SatcomRadio/DiseqC_Controller/Kicad/3D/SMA.step

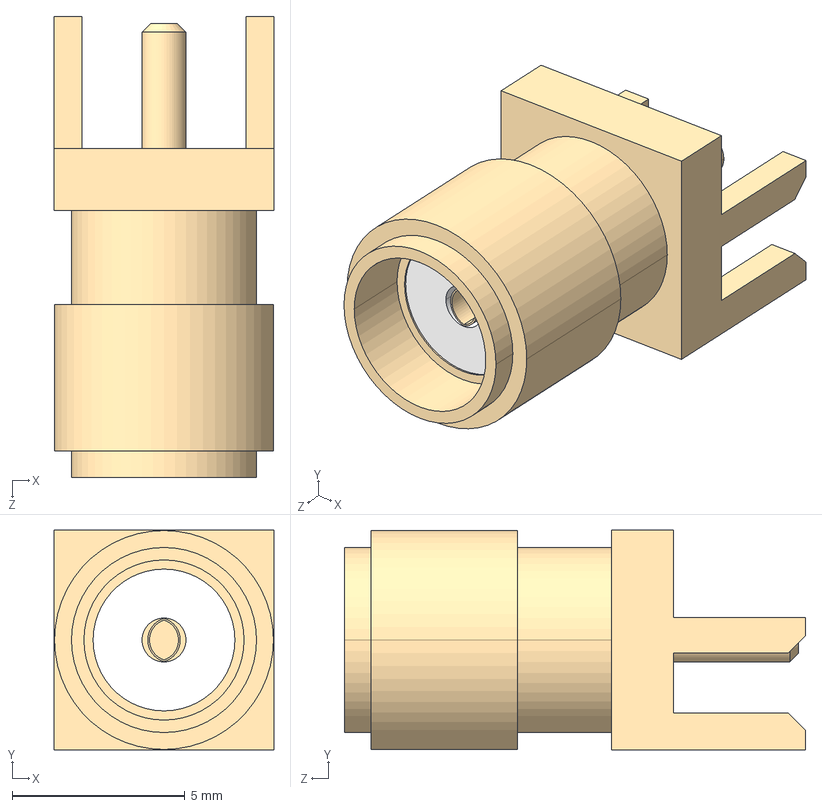
[picture p8: CAD file, 2025-11-17]
Kicad/3D/SMA.step
6.35 x 6.35 x 13.3 mm
