SatcomRadio/DiseqC_Controller/Kicad/3D/StepUp_2A.STEP

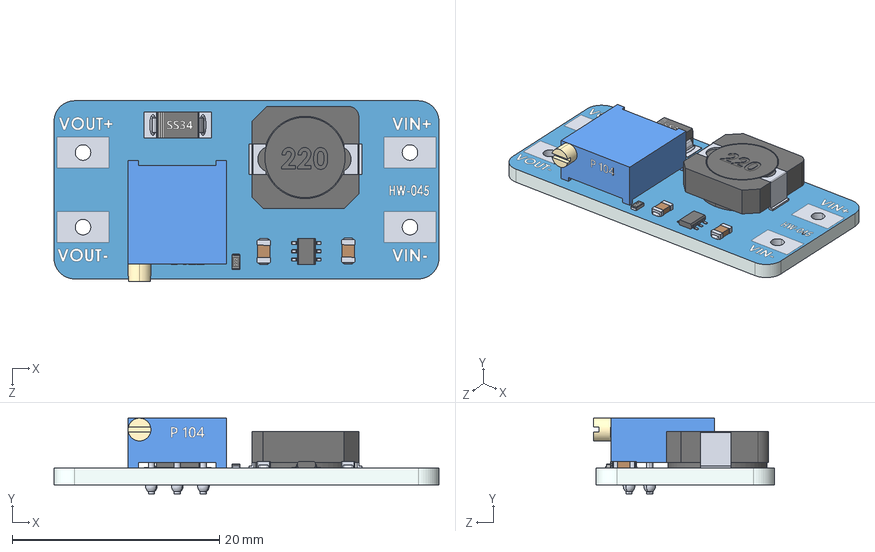
[picture p9: CAD file, 2025-11-17]
Kicad/3D/StepUp_2A.STEP
37.1 x 7.30 x 17.4 mm
MT3608 Converter PCB
smdS537diode
tinySMDResistor222
smdceramiccapacitorbrown x 2
tinysmdChip6pin
HorizonatalTrimmerP104
solder x 3
smbInductor220
