SatcomRadio/DiseqC_Controller/Kicad/3D/SMD_Inductor.step

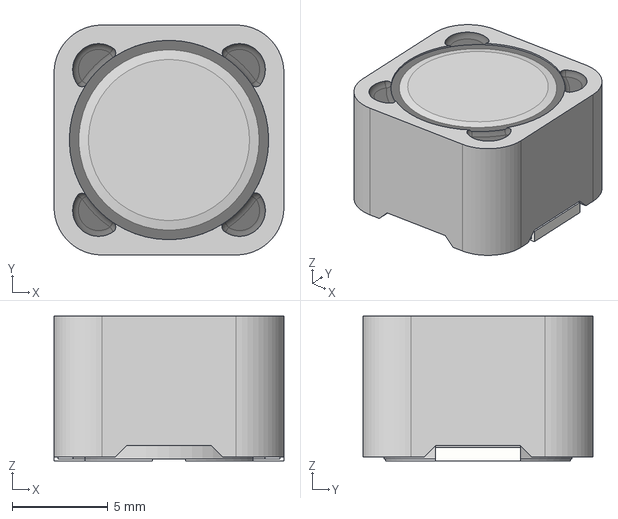
[picture p10: CAD file, 2025-11-17]
Kicad/3D/SMD_Inductor.step
12.0 x 12.0 x 7.56 mm
