SatcomRadio/DiseqC_Controller/Kicad/3D/SMA-angled.STEP

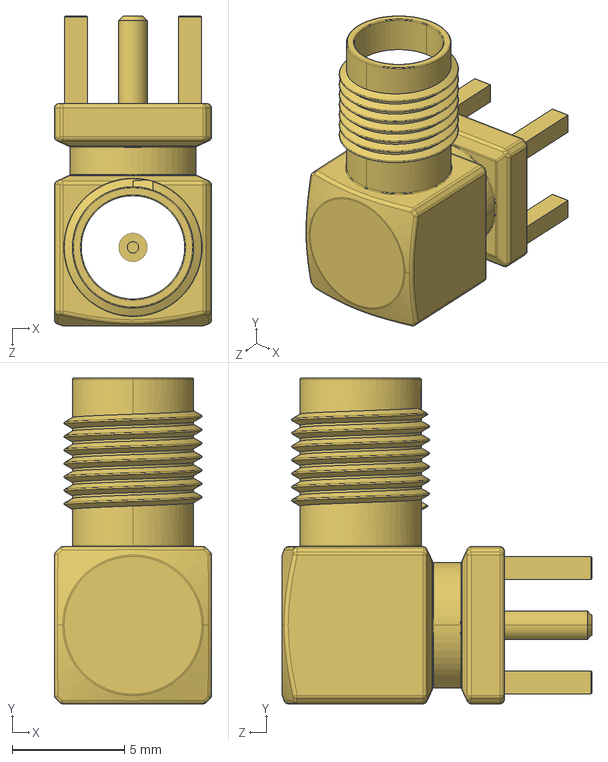
[picture p11: CAD file, 2025-10-04]
Kicad/3D/SMA-angled.STEP
7.00 x 14.5 x 13.8 mm
