SatcomRadio/DiseqC_Controller/Kicad/DiseqController_SMD.kicad_pcb

## KiCad design Kicad/DiseqController_SMD.kicad_pcb (2025-11-22)

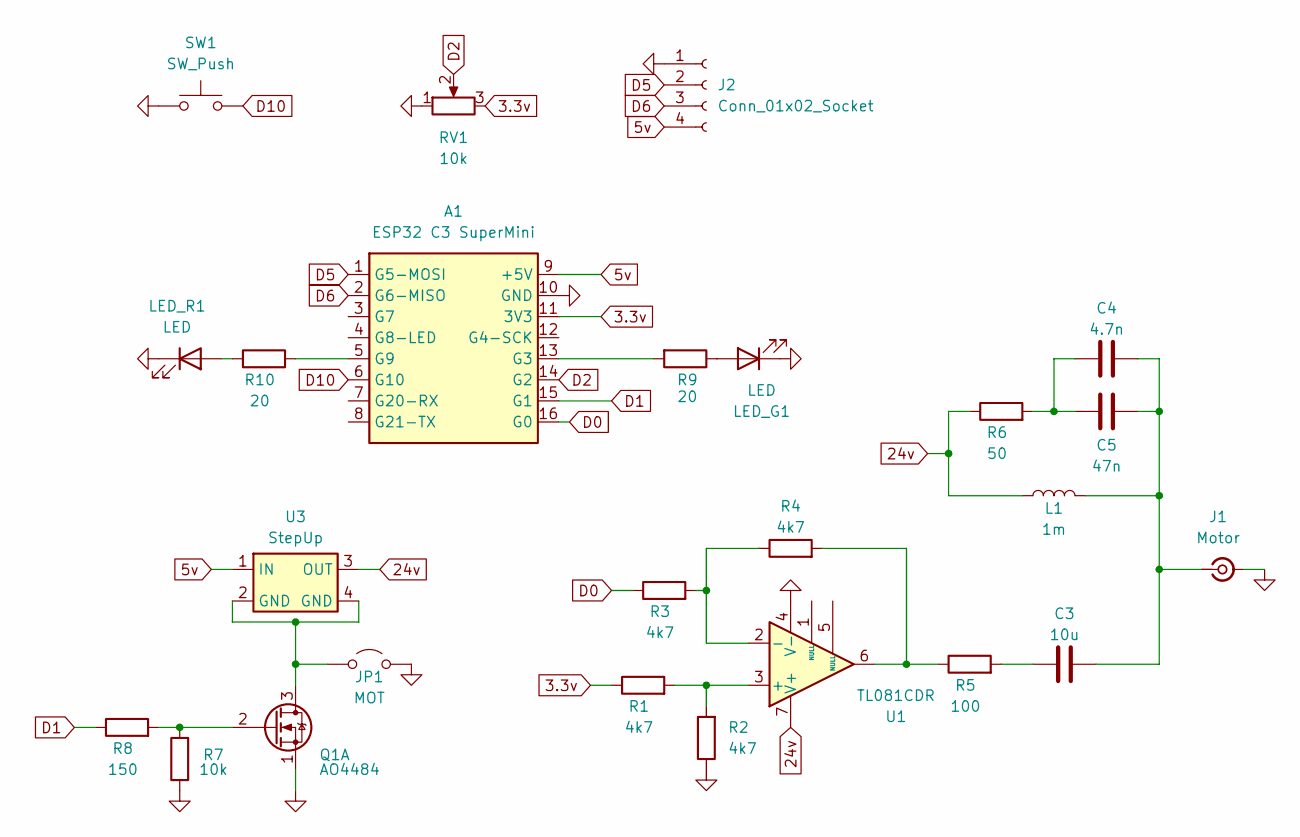
[picture p12: schematic DiseqController_SMD.kicad_sch]

Parts:
A1: ESP32 C3 SuperMini; ESP32SuperMini
C3: 10u; C_0805_2012Metric_Pad1.18x1.45mm_HandSolder
C4: 4.7n; C_0805_2012Metric_Pad1.18x1.45mm_HandSolder
C5: 47n; C_0805_2012Metric_Pad1.18x1.45mm_HandSolder
J1: Motor; SMA_Edge
J2: Conn_01x02_Socket; PinHeader_1x04_P2.54mm_Vertical
JP1: MOT; SolderJumper-2_P1.3mm_Open_Pad1.0x1.5mm
L1: 1m; Indcutor_12x12mm_H6mm
LED_G1: LED; Bent_LED_3mm
LED_R1: LED; Bent_LED_3mm
Q1: AO4484
R1, R2, R3, R4: 4k7; R_0805_2012Metric_Pad1.20x1.40mm_HandSolder
R5: 100; R_0805_2012Metric_Pad1.20x1.40mm_HandSolder
R6: 50; R_0805_2012Metric_Pad1.20x1.40mm_HandSolder
R7: 10k; R_0805_2012Metric_Pad1.20x1.40mm_HandSolder
R8: 150; R_0805_2012Metric_Pad1.20x1.40mm_HandSolder
R9, R10: 20; R_0805_2012Metric_Pad1.20x1.40mm_HandSolder
RV1: 10k; PinHeader_1x03_P2.54mm_Vertical
SW1: SW_Push; PinHeader_1x02_P2.54mm_Vertical
U1: TL081CDR; SOIC-8_3.9x4.9mm_P1.27mm
U3: StepUp; StepUp_2A

Connections:
3.3v: A1.11 (3V3), R1.1, RV1.3
5v: A1.9 (+5V), J2.4, U3.1 (IN)
24v: L1.1, R6.1, U1.7 (V+), U3.3 (OUT)
D0: A1.16 (G0), R3.1
D1: A1.15 (G1), R8.1
D2: A1.14 (G2), RV1.2
D5: A1.1 (G5-MOSI), J2.2
D6: A1.2 (G6-MISO), J2.3
D10: A1.6 (G10), SW1.2
GND: A1.10 (GND), J1.2 (Ext), J2.1, JP1.2 (B), LED_G1.1 (K), LED_R1.1 (K), Q1.1 (S1), R2.1, R7.1, RV1.1, SW1.1, U1.4 (V-)
unnamed: A1.13 (G3), R9.2
unnamed: A1.5 (G9), R10.2
unnamed: C3.2, R5.2
unnamed: C4.2, C5.2, R6.2
unnamed: C3.1, C4.1, C5.1, J1.1 (In), L1.2
unnamed: JP1.1 (A), Q1.3 (D1), U3.2 (GND), U3.4 (GND)
unnamed: LED_G1.2 (A), R9.1
unnamed: LED_R1.2 (A), R10.1
unnamed: Q1.2 (G1), R7.2, R8.2
unnamed: R4.2, R5.1, U1.6
unnamed: R1.2, R2.2, U1.3 (+)
unnamed: R3.2, R4.1, U1.2 (-)

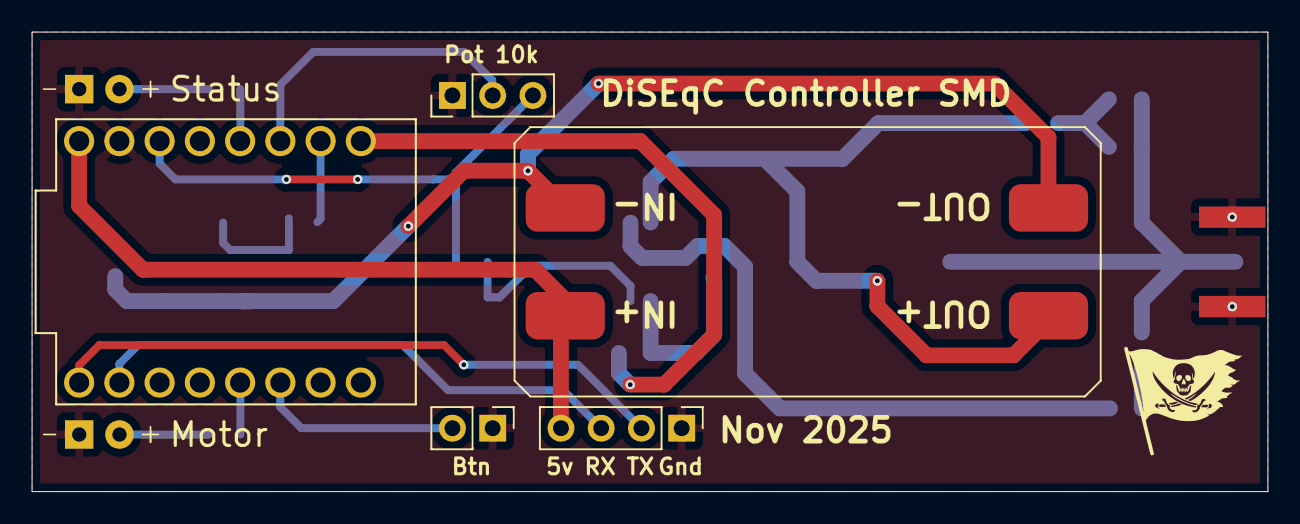
[picture p13: board DiseqController_SMD.kicad_pcb from above]

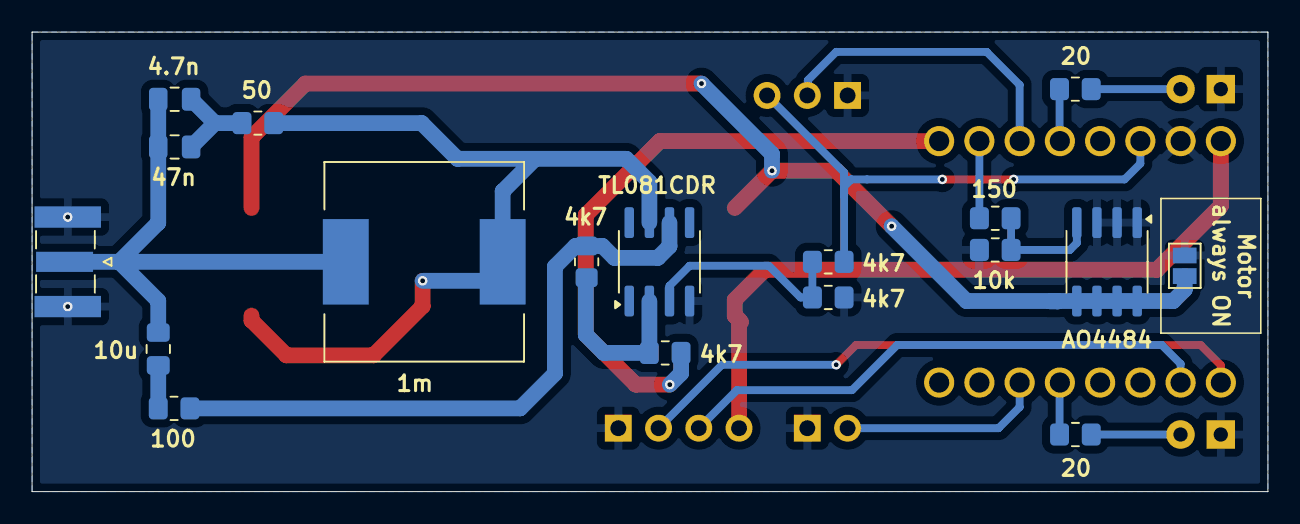
[picture p14: board DiseqController_SMD.kicad_pcb from below]

Board: 2 copper layers, 78.0 x 29.0 mm, 25 parts (18 on the bottom side), 22 nets.
