SatcomRadio/DiseqC_Controller/(commit log)

2025-10-04 Fix silkscreen
    [DiseqController.kicad_pcb]
2025-10-04 Updated component
    [DiseqController.kicad_pcb, DiseqController.kicad_sch]
2025-11-17 Added SMD version with more stuff
    [DiseqController_SMD.kicad_pcb, DiseqController_SMD.kicad_sch, SMA.step, SMD_Inductor.step, StepUp_2A.STEP]
2025-11-22 update info
    [DiseqController.kicad_pcb, DiseqController.kicad_sch, DiseqController_SMD.kicad_pcb]
